aidanchan0623/um-robocon-can-platform/THIRD_PARTY_NOTICES.md

# Attribution and licensing

This public portfolio archive has **no newly selected project-wide license** for the team's original board designs, application code, documentation or media. Publication and a future open-source licensing decision are separate: no blanket license is added by this release. Any future project license should be agreed with the contributors and distinguish original material from third-party components.

STM32Cube-generated files retain their original STMicroelectronics headers. Each firmware project vendors the HAL driver and the CMSIS headers used by its build. Preserve and consult the `LICENSE.txt` files within `Drivers`, the CMSIS device folder, and any individual source-file notices; these components retain their respective ST/BSD and Arm/Apache licensing terms rather than acquiring a new license from this repository.

The VESC packet interface is documented with links to upstream sources. This repository does not include the complete VESC firmware, VESC Tool distribution, manufacturer firmware images or per-motor calibration backups. The small application encoder/decoder files are from the AI-assisted STM32 project developed during the team's tests; they are not presented as original invention of the VESC protocol.

EasyEDA exports contain library part/footprint metadata and contributor identifiers. Inclusion of a design snapshot does not claim ownership of third-party library symbols or footprints.

README organisation was inspired by [bjpirt/shutter-tester](https://github.com/bjpirt/shutter-tester); its implementation, prose and license were not copied.
