aidanchan0623/um-robocon-can-platform/docs/media-gallery.md

# Prototype and debugging gallery

I added these photographs and the video on 2 October 2026. Original media bytes are retained under descriptive filenames. The supply date and WhatsApp filenames do not independently establish recording dates. Captions distinguish visible observations from the separate test records.

## Complete PCB layout

Whole CANDrive v1 PCB in EasyEDA

*Actual EasyEDA capture of the September 27 PCB export, with copper pours hidden for trace visibility. I explain the board's two functions and the header, routing, TVS and CMC trade-offs in [PCB design decisions](pcb-design-decisions.md).*

## CANDrive v1 bare PCB

Bare CANDrive v1 PCB with labelled CAN, external MCU, PWM, encoder, UART and debug connections

This photograph shows our bare CANDrive v1 PCB and its labelled interfaces. Assembled-board and solder-repair close-ups remain useful follow-ups. Basic onboard PWM and bidirectional encoder feedback are now demonstrated in the separate 10 October milestone below; calibrated accuracy remains pending.

## 10 October: CAN-driven PWM and encoder feedback

Annotated IG42 CANDrive bench

The lower PCB is our CANDrive used as the F303's external CAN transceiver without a populated local MCU. The upper CANDrive's G431 controls the motor driver and acquires A/B encoder feedback. The coloured encoder bundle and MCU TX/RX versus CANH/CANL paths are labelled separately. This AI-assisted annotation is context, not a schematic; [original photo](../evidence/pwm-encoder-2026-10-10/bench-setup-original.jpg) and prompts are preserved.

[Video 1](../evidence/pwm-encoder-2026-10-10/motor-encoder-demo-01-original.mp4) (about 26 s) · [Video 2](../evidence/pwm-encoder-2026-10-10/motor-encoder-demo-02-original.mp4) (about 15 s). These demonstrate keyboard motor control and signed encoder feedback, not PID, calibrated RPM or endurance. Original audio is retained. See [test scope and unresolved startup/calibration limits](pwm-encoder-bringup.md).

## Two-motor bench

Bench arrangement with two motors, controllers, custom board, Nucleo and test wiring

I photographed the bench arrangement to show the motors, controllers, custom board and Nucleo. I document the controller identities and observed motor responses separately in my [test notes](verification.md).

### Demonstration video

[Open/download the original bench video](../evidence/videos/bench-demo-supplied-2026-10-02.mp4) — approximately 20.8 seconds, 3.38 MB.

I recorded the motors and wiring, followed by the laptop’s two-motor G474 keyboard-control interface. A 6374 190KV motor label is visible. Note: this is a short demonstration of the setup. I still need independent payload, latency, calibrated speed and loaded-torque measurements. I have not established that the clip matches the timing of the 1 October logs.

The video is preserved with its original audio. Playback support varies by GitHub client; use the file's download option if inline playback is unavailable.

## My SWD debugging captures

In these captures, I probed the debug interface: **CH1/yellow is SWCLK; CH2/green is SWDIO**. Both channels display DC coupling, 10:1 attenuation and 1 V/div.

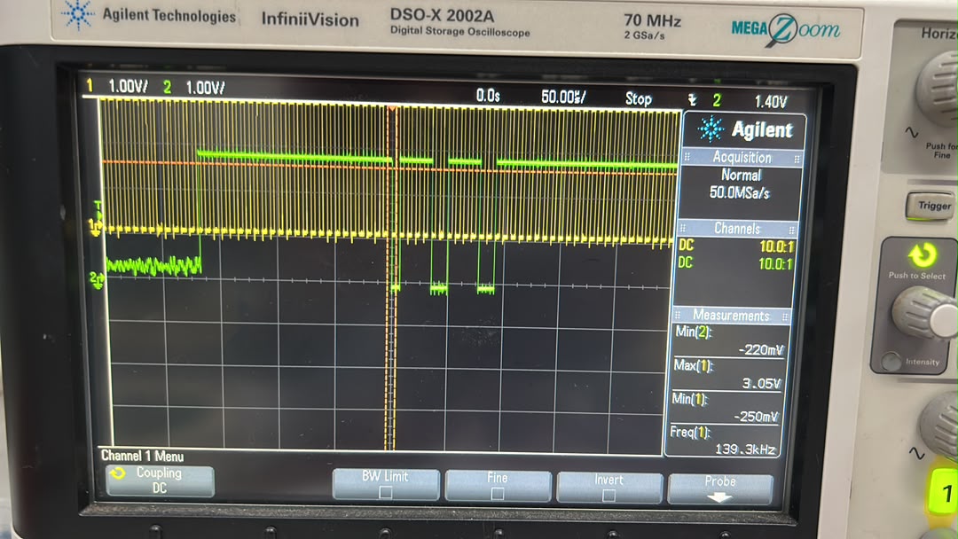
[picture p9: evidence/images/swd-clock-data-wide.jpeg]
SWCLK and SWDIO capture at 50 microseconds per division


Wide view at **50 µs/div**. The scope displays CH1 maximum 3.05 V, CH1 minimum −250 mV, CH2 minimum −220 mV and a CH1 frequency reading of 139.3 kHz. These are displayed scope measurements, not independently calibrated values or a guarantee of the programmer's configured clock rate.

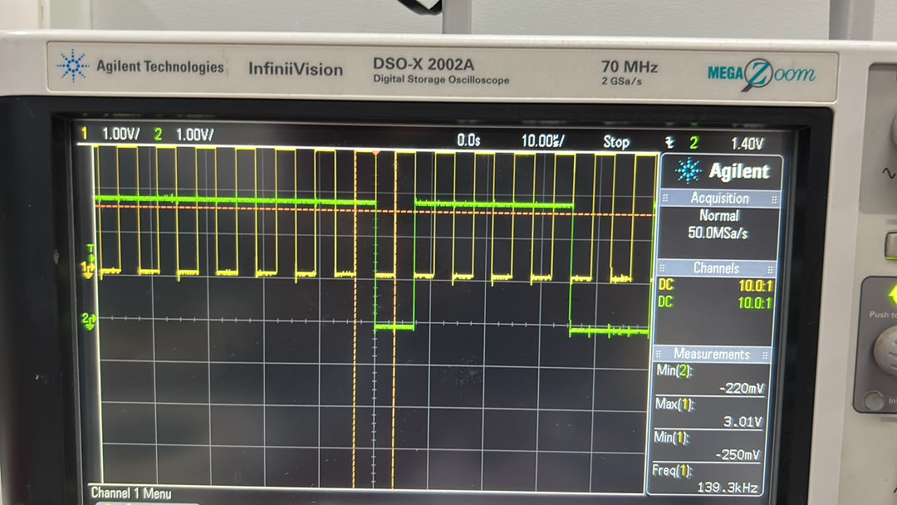
[picture p10: evidence/images/swd-clock-data-detail.jpeg]
SWCLK and SWDIO detail at 10 microseconds per division


Detail at **10 µs/div**. My scope displays a CH1 maximum of 3.01 V, with minima of −250 mV on CH1 and −220 mV on CH2. Note: I captured clock and data transitions without decoding the SWD transactions. I still need to assess the probing and undershoot before drawing conclusions about MCU damage.

Note: I took these captures during the separate debug-interface investigation. I still need CANH/CANL measurements and decoded UART/CAN records to document those signal paths.

## Earlier EasyEDA schematic — design history only

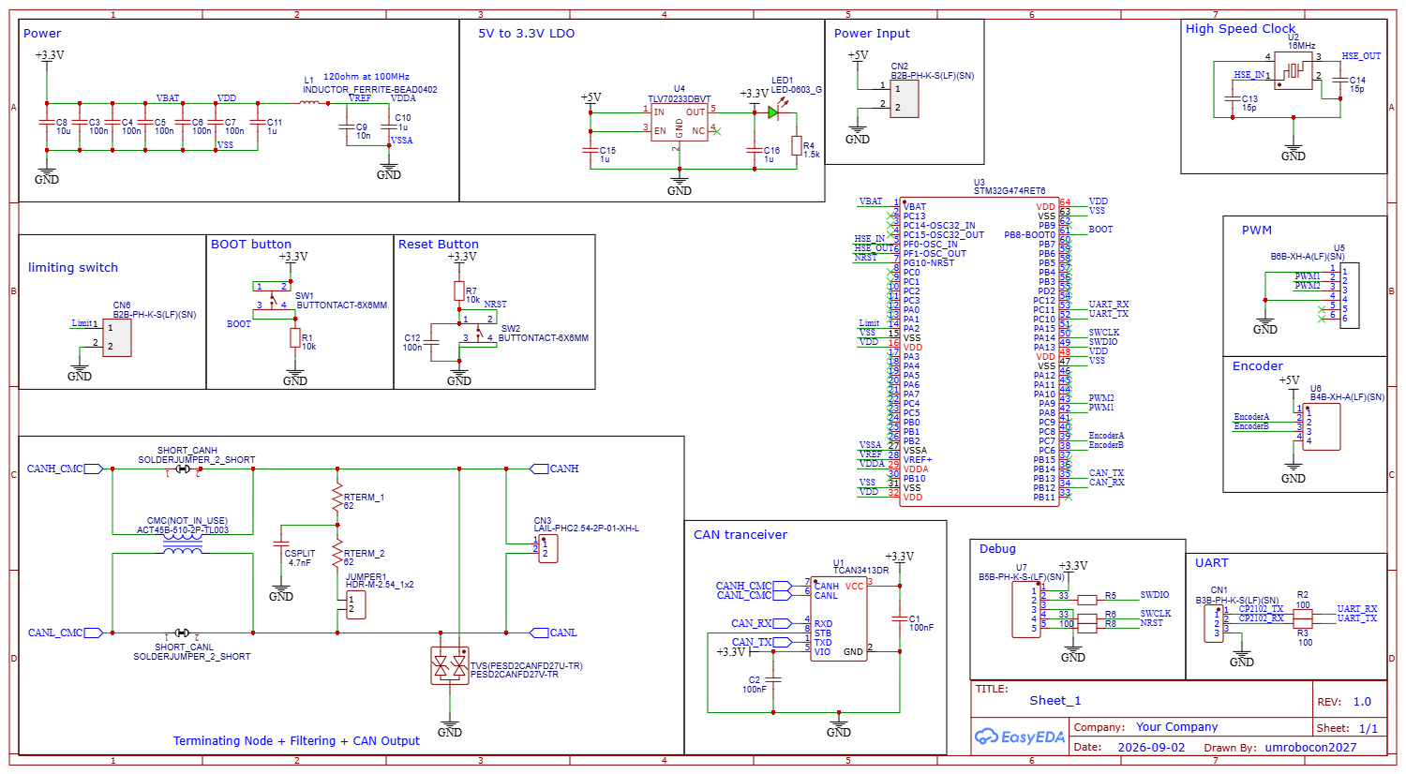
[picture p11: hardware/images/schematic-2026-09-04-historical.png]
Historical EasyEDA schematic export showing an earlier STM32G474 design


This original export has a filename dated **4 September 2026**. It shows STM32G474RET6 with CAN on PB13/PB12, unlike the later STM32G431RBT6 revision documented in this repository. It is included to show design development, **not as the wiring reference for the current board**.

Use the [27 September EasyEDA source exports](../hardware/source) and [hardware notes](../hardware/README.md) for the documented revision. I reconstructed the [CAN signal-path diagram](../hardware/images/can_routing.png) from that later PCB export to explain the connections; I use the original exports for fabrication.

## Photos and measurements I plan to add

- Close-ups of the assembled PCB and the repaired TCAN3413 lead-to-pad joints.
- Annotated, repeatable CANH/CANL measurements before and after repair.
- Independently decoded CAN frames and a 1 Mbit/s CANH/CANL edge capture; the separate [byte/sequence echo test](verification.md) is already recorded.
- Repaired SWDIO joint photograph, measured continuity and a verified G431 UART capture after reset.
- Loaded and multi-node testing before making robot-level performance claims.
