aidanchan0623/um-robocon-can-platform/evidence/pwm-encoder-2026-10-10/bench-setup-original.jpg

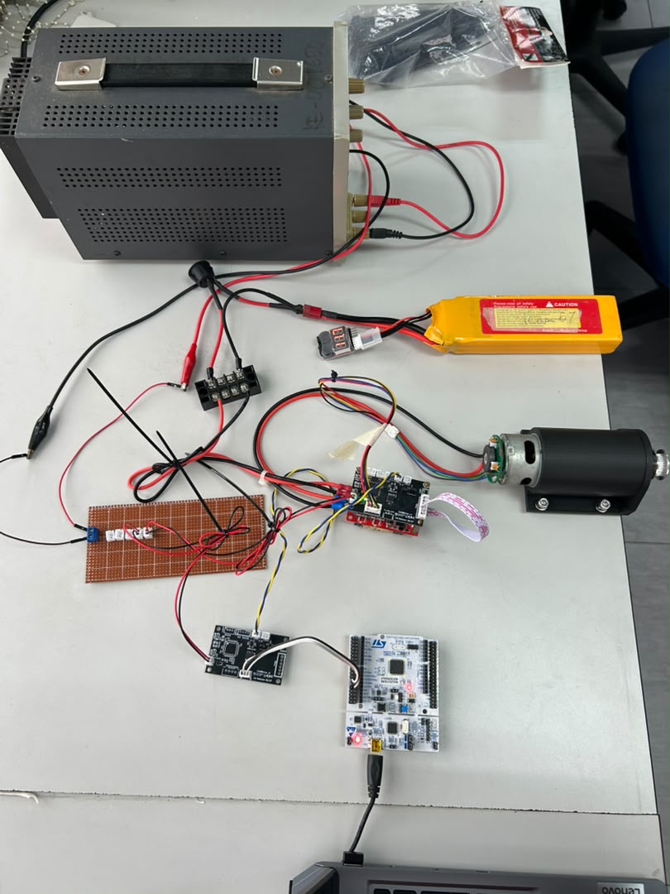
evidence/pwm-encoder-2026-10-10/bench-setup-original.jpg
