aidanchan0623/um-robocon-can-platform/(list of files, drawings)

Other design files:
hardware/source/PCB_PCB_CAN-Board-V1_2026-09-27.json
hardware/source/SCH_CAN-Board-V1_2026-09-27.json
