aidanchan0623/um-robocon-can-platform/evidence/can-1mbit-2026-10-05/firmware-overlays/f303-can-reply/F303_G474_CAN_B.ioc

Mcu.UserName=STM32F303RETx
PA11.Signal=CAN_RX
PA12.Signal=CAN_TX
PA13.Signal=SYS_JTMS-SWDIO
PA14.Signal=SYS_JTCK-SWCLK
PA5.GPIO_Label=LD2
PA5.Signal=GPIO_Output
