aidanchan0623/um-robocon-can-platform/firmware/g474-can-ping/Core/Src/main.c

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
/* Includes ------------------------------------------------------------------*/
#include "main.h"

/* USER CODE BEGIN PD */
#define NODE_A  1  // G474 sends CAN pings to the F303.
/* USER CODE END PD */

FDCAN_HandleTypeDef hfdcan1;

/* USER CODE BEGIN PV */
volatile uint32_t canQueued = 0;
volatile uint32_t canCompleted = 0;
volatile uint32_t canLastError = 0;
volatile uint32_t canTxError = 0;
/* USER CODE END PV */

void SystemClock_Config(void);
static void MX_GPIO_Init(void);
static void MX_FDCAN1_Init(void);
/**
  * @brief  The application entry point.
  * @retval int
  */
int main(void)
{

  /* MCU Configuration--------------------------------------------------------*/

  /* Reset of all peripherals, Initializes the Flash interface and the Systick. */
  HAL_Init();

  /* Configure the system clock */
  SystemClock_Config();

  /* Initialize all configured peripherals */
  MX_GPIO_Init();
  MX_FDCAN1_Init();
  /* USER CODE BEGIN 2 */
  FDCAN_FilterTypeDef filter = {0};
  filter.IdType = FDCAN_STANDARD_ID;
  filter.FilterIndex = 0;
  filter.FilterType = FDCAN_FILTER_MASK;
  filter.FilterConfig = FDCAN_FILTER_TO_RXFIFO0;
  filter.FilterID1 = 0;
  filter.FilterID2 = 0;  // Accept all standard IDs

  if (HAL_FDCAN_ConfigFilter(&hfdcan1, &filter) != HAL_OK) Error_Handler();
  if (HAL_FDCAN_ConfigGlobalFilter(&hfdcan1,
          FDCAN_REJECT, FDCAN_REJECT,
          FDCAN_REJECT_REMOTE, FDCAN_REJECT_REMOTE) != HAL_OK) Error_Handler();
  if (HAL_FDCAN_Start(&hfdcan1) != HAL_OK) Error_Handler();

  FDCAN_TxHeaderTypeDef tx = {0};
  tx.IdType = FDCAN_STANDARD_ID;
  tx.TxFrameType = FDCAN_DATA_FRAME;
  tx.DataLength = FDCAN_DLC_BYTES_1;
  tx.ErrorStateIndicator = FDCAN_ESI_ACTIVE;
  tx.BitRateSwitch = FDCAN_BRS_OFF;
  tx.FDFormat = FDCAN_CLASSIC_CAN;
  tx.TxEventFifoControl = FDCAN_NO_TX_EVENTS;
  tx.MessageMarker = 0;

  uint8_t txData[1] = {0x55};
#if NODE_A
  uint32_t lastTx = HAL_GetTick();
#endif
  /* USER CODE END 2 */

  /* Infinite loop */
  /* USER CODE BEGIN WHILE */
  while (1)
  {
    /* USER CODE END WHILE */

    /* USER CODE BEGIN 3 */
#if NODE_A
if (HAL_GetTick() - lastTx >= 500) {
    lastTx = HAL_GetTick();
    tx.Identifier = 0x123;
    if (HAL_FDCAN_GetTxFifoFreeLevel(&hfdcan1) > 0) {
    	if (HAL_FDCAN_AddMessageToTxFifoQ(&hfdcan1, &tx, txData) == HAL_OK)
    	    canQueued++;
    }
}
#endif

if (HAL_FDCAN_GetRxFifoFillLevel(&hfdcan1, FDCAN_RX_FIFO0) > 0) {
    FDCAN_RxHeaderTypeDef rx;
    uint8_t rxData[8];

    if (HAL_FDCAN_GetRxMessage(&hfdcan1, FDCAN_RX_FIFO0,
                               &rx, rxData) == HAL_OK) {
#if NODE_A
        if (rx.Identifier == 0x124) {
            HAL_GPIO_TogglePin(GPIOA, GPIO_PIN_5); // Reply received from F303
        }
#else
        if (rx.Identifier == 0x123) {
            HAL_GPIO_TogglePin(GPIOA, GPIO_PIN_5); // Ping received
            tx.Identifier = 0x124;
            if (HAL_FDCAN_GetTxFifoFreeLevel(&hfdcan1) > 0) {
                HAL_FDCAN_AddMessageToTxFifoQ(&hfdcan1, &tx, txData);
            }
        }
#endif
    }
}
if (__HAL_FDCAN_GET_FLAG(&hfdcan1, FDCAN_FLAG_TX_COMPLETE)) {
    canCompleted++;
    __HAL_FDCAN_CLEAR_FLAG(&hfdcan1, FDCAN_FLAG_TX_COMPLETE);
}

FDCAN_ProtocolStatusTypeDef status;
FDCAN_ErrorCountersTypeDef errors;
if (HAL_FDCAN_GetProtocolStatus(&hfdcan1, &status) == HAL_OK)
    canLastError = status.LastErrorCode;
if (HAL_FDCAN_GetErrorCounters(&hfdcan1, &errors) == HAL_OK)
    canTxError = errors.TxErrorCnt;
HAL_Delay(1);
  }
  /* USER CODE END 3 */
}

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
