aidanchan0623/um-robocon-can-platform/(commit log)

2026-10-02 Document CAN prototype, hardware debugging and STM32/VESC bench tests
    [PCB_PCB_CAN-Board-V1_2026-09-27.json, SCH_CAN-Board-V1_2026-09-27.json]
2026-10-02 Add prototype photos, SWD captures and bench demo media
2026-10-02 Correct PWM and encoder contributor attribution
2026-10-04 Explain CANDrive purpose and PCB layout trade-offs
2026-10-05 Record audited CAN integrity and 30 minute endurance evidence
    [stage-100-samples.csv, stage-1000-preflight1-samples.csv, stage-1000-samples.csv, stage-2500-samples.csv]
2026-10-05 Document validation methods, firmware provenance and SWDIO assembly lesson
2026-10-10 Archive PWM encoder control source snapshot and offline tests
2026-10-10 Add original motor encoder videos and CAN bring-up evidence
2026-10-10 Document onboard CAN PWM and bidirectional encoder milestone
