aidanchan0623/um-robocon-can-platform/(notices)

Notices in the files:
firmware/g474-can-ping/Core/Src/main.c:
Copyright (c) 2026 STMicroelectronics.
All rights reserved.
This software is licensed under terms that can be found in the LICENSE file
